kostakey/CountdownTimer/README.md

# Countdown Timer

## Starting a New Project
[help](https://docs.espressif.com/projects/vscode-esp-idf-extension/en/latest/startproject.html)
