kostakey/CountdownTimer/CountdownTimerOrderingSheet.xlsx

Sheet: OrderingList
Name | Description | Quantity | MFG PN | Cost per Unit | Price | Link | TOTAL
ESP32 C3 | MCU | 2 | ESP32-C3-WROOM-02-N4 | $3.380 | $6.760 | https://www.digikey.com/en/products/detail/espressif-systems/ESP32-C3-WROOM-02-N4/14553031 | $117.710
TLV1117LV33 | 3.3V LDO | 2 | TLV1117LV33DCYR | $0.260 | $0.520 | https://www.digikey.com/en/products/detail/texas-instruments/TLV1117LV33DCYR/2666508
0603 1u Cap |  | 15 | CL10B105KO8NNNC | $0.037 | $0.555 | https://www.digikey.com/en/products/detail/samsung-electro-mechanics/CL10B105KO8NNNC/3886677
12V-5V DCDC | 12V-5V DCDC, 0.5A, 6W | 2 | R-78E5.0-1.0 | $3.970 | $7.940 | https://www.digikey.com/en/products/detail/recom-power/R-78E5-0-1-0/4930585
0805 10u Cap | 10%, 16V, MLCC | 10 | CL21A106KOFNNNE | $0.091 | $0.910 | https://www.digikey.com/en/products/detail/samsung-electro-mechanics/CL21A106KOFNNNE/3888551
USB-UART Bridge |  | 2 | CP2102N-A02-GQFN28R | $5.100 | $10.200 | https://www.digikey.com/en/products/detail/silicon-labs/CP2102N-A02-GQFN28R/9863480
NPN Transistor | 40V, 0.6A | 4 | MMBT4401-7-F | $0.140 | $0.560 | https://www.digikey.com/en/products/detail/diodes-incorporated/MMBT4401-7-F/775841
USB-C Receptacle |  | 2 | 12401610E4#2A | $1.350 | $2.700 | https://www.digikey.com/en/products/detail/amphenol-cs-commercial-products/12401610E4-2A/5775519
TVS Diode | 19.9VC | 4 | SMAJ12CA | $0.480 | $1.920 | https://www.digikey.com/en/products/detail/littelfuse-inc/SMAJ12CA/762271
Schottky Diode | 40V, 1A | 2 | 1N5819HW-7-F | $0.290 | $0.580 | https://www.digikey.com/en/products/detail/diodes-incorporated/1N5819HW-7-F/814970
SPST Push Button |  | 3 | KMR213G LFG | $1.060 | $3.180 | https://www.digikey.com/en/products/detail/c-k/KMR213G-LFG/2176540
LED Driver, 8-Ch | Shift Registers, Current Sink | 10 | TLC5916IDR | $1.094 | $10.940 | https://www.digikey.com/en/products/detail/texas-instruments/TLC5916IDR/1726504
Red LEDs | Packs of 100 | 3 |  | $6.990 | $20.970 | https://www.amazon.com/dp/B077X95F7C?ref=ppx_yo2ov_dt_b_fed_asin_title&th=1
12VDC Barrel Jack Receptacle |  | 2 | PJ-063AH | $1.490 | $2.980 | https://www.digikey.com/en/products/detail/same-sky-formerly-cui-devices/PJ-063AH/2161208
Black FR4 | 2mm thick, 30cm x 17cm | 1 |  | $8.990 | $8.990 | https://www.amazon.com/gp/product/B0G6F9HTTK/ref=ewc_pr_img_2?smid=A3D5GC7GV7VRAI&psc=1
Perf board | Variety | 1 |  | $7.990 | $7.990 | https://www.amazon.com/gp/product/B0DBZ1BXFZ/ref=ewc_pr_img_2?smid=A1Z1ENBD0KSZ4W&psc=1
PCB headers |  | 1 |  | $10.990 | $10.990 | https://www.amazon.com/gp/product/B0774VBJ3J/ref=ewc_pr_img_1?smid=A3AX24NME6J6T3&th=1
0603 3A Fuse |  | 3 | SF-0603FP300-2 | $0.990 | $2.970 | https://www.digikey.com/en/products/detail/bourns-inc/SF-0603FP300-2/6153649
12V Wall Adapter |  | 1 |  | $12.990 | $12.990 | amazon.com/gp/product/B01GEA8PQA/ref=ox_sc_act_title_1?smid=AA0YO4F2UD50F&psc=1
0603 0 Res | 1/10W | 25 | RC0603JR-070RL | $0.009 | $0.220 | https://www.digikey.com/en/products/detail/yageo/RC0603JR-070RL/726675
0603 10k Res | 1/10W | 25 | RC0603FR-0710KL | $0.019 | $0.470 | https://www.digikey.com/en/products/detail/yageo/RC0603FR-0710KL/726880
0603 0.1u Cap | 16V | 25 | CL10B104KO8NNNC | $0.027 | $0.675 | https://www.digikey.com/en/products/detail/samsung-electro-mechanics/CL10B104KO8NNNC/3886663
0603 1k Res | 1/8W | 25 | CRCW06031K00FKEA | $0.024 | $0.600 | https://www.digikey.com/en/products/detail/vishay-dale/CRCW06031K00FKEA/1174668
0603 22.1k Res | 1/10W | 10 | RC0603FR-0722K1L | $0.025 | $0.250 | https://www.digikey.com/en/products/detail/yageo/RC0603FR-0722K1L/727058
0603 47.5k Res | 1/10W | 10 | RMCF0603FT47K5 | $0.021 | $0.210 | https://www.digikey.com/en/products/detail/stackpole-electronics-inc/RMCF0603FT47K5/1761143
0805 1.2k Res | Current limiting resistor | 25 | RC0805FR-071K2L | $0.026 | $0.640 | https://www.digikey.com/en/products/detail/yageo/RC0805FR-071K2L/727466

Sheet: PartsList
Name | Description | Designator | Quantity | MFG PN | Cost per Unit | Price | Link | TOTAL
 |  |  |  |  |  | #VALUE! |  | #VALUE!
 |  |  |  |  |  | #VALUE!
 |  |  |  |  |  | #VALUE!
 |  |  |  |  |  | #VALUE!
 |  |  |  |  |  | #VALUE!
 |  |  |  |  |  | #VALUE!
 |  |  |  |  |  | #VALUE!
 |  |  |  |  |  | #VALUE!
