kostakey/CountdownTimer/src/hardware/drillTemplate.pdf

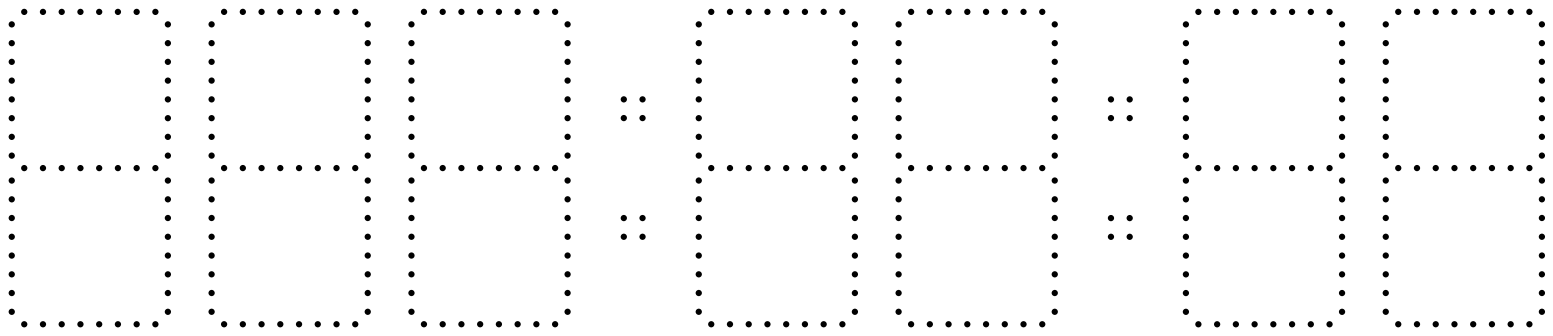
[picture p1: page 1]
