kostakey/CountdownTimer/src/hardware/CountdownTimerController/CountdownTimerController_V1.0.kicad_pcb

## KiCad design src/hardware/CountdownTimerController/CountdownTimerController_V1.0.kicad_pcb (2026-06-29)

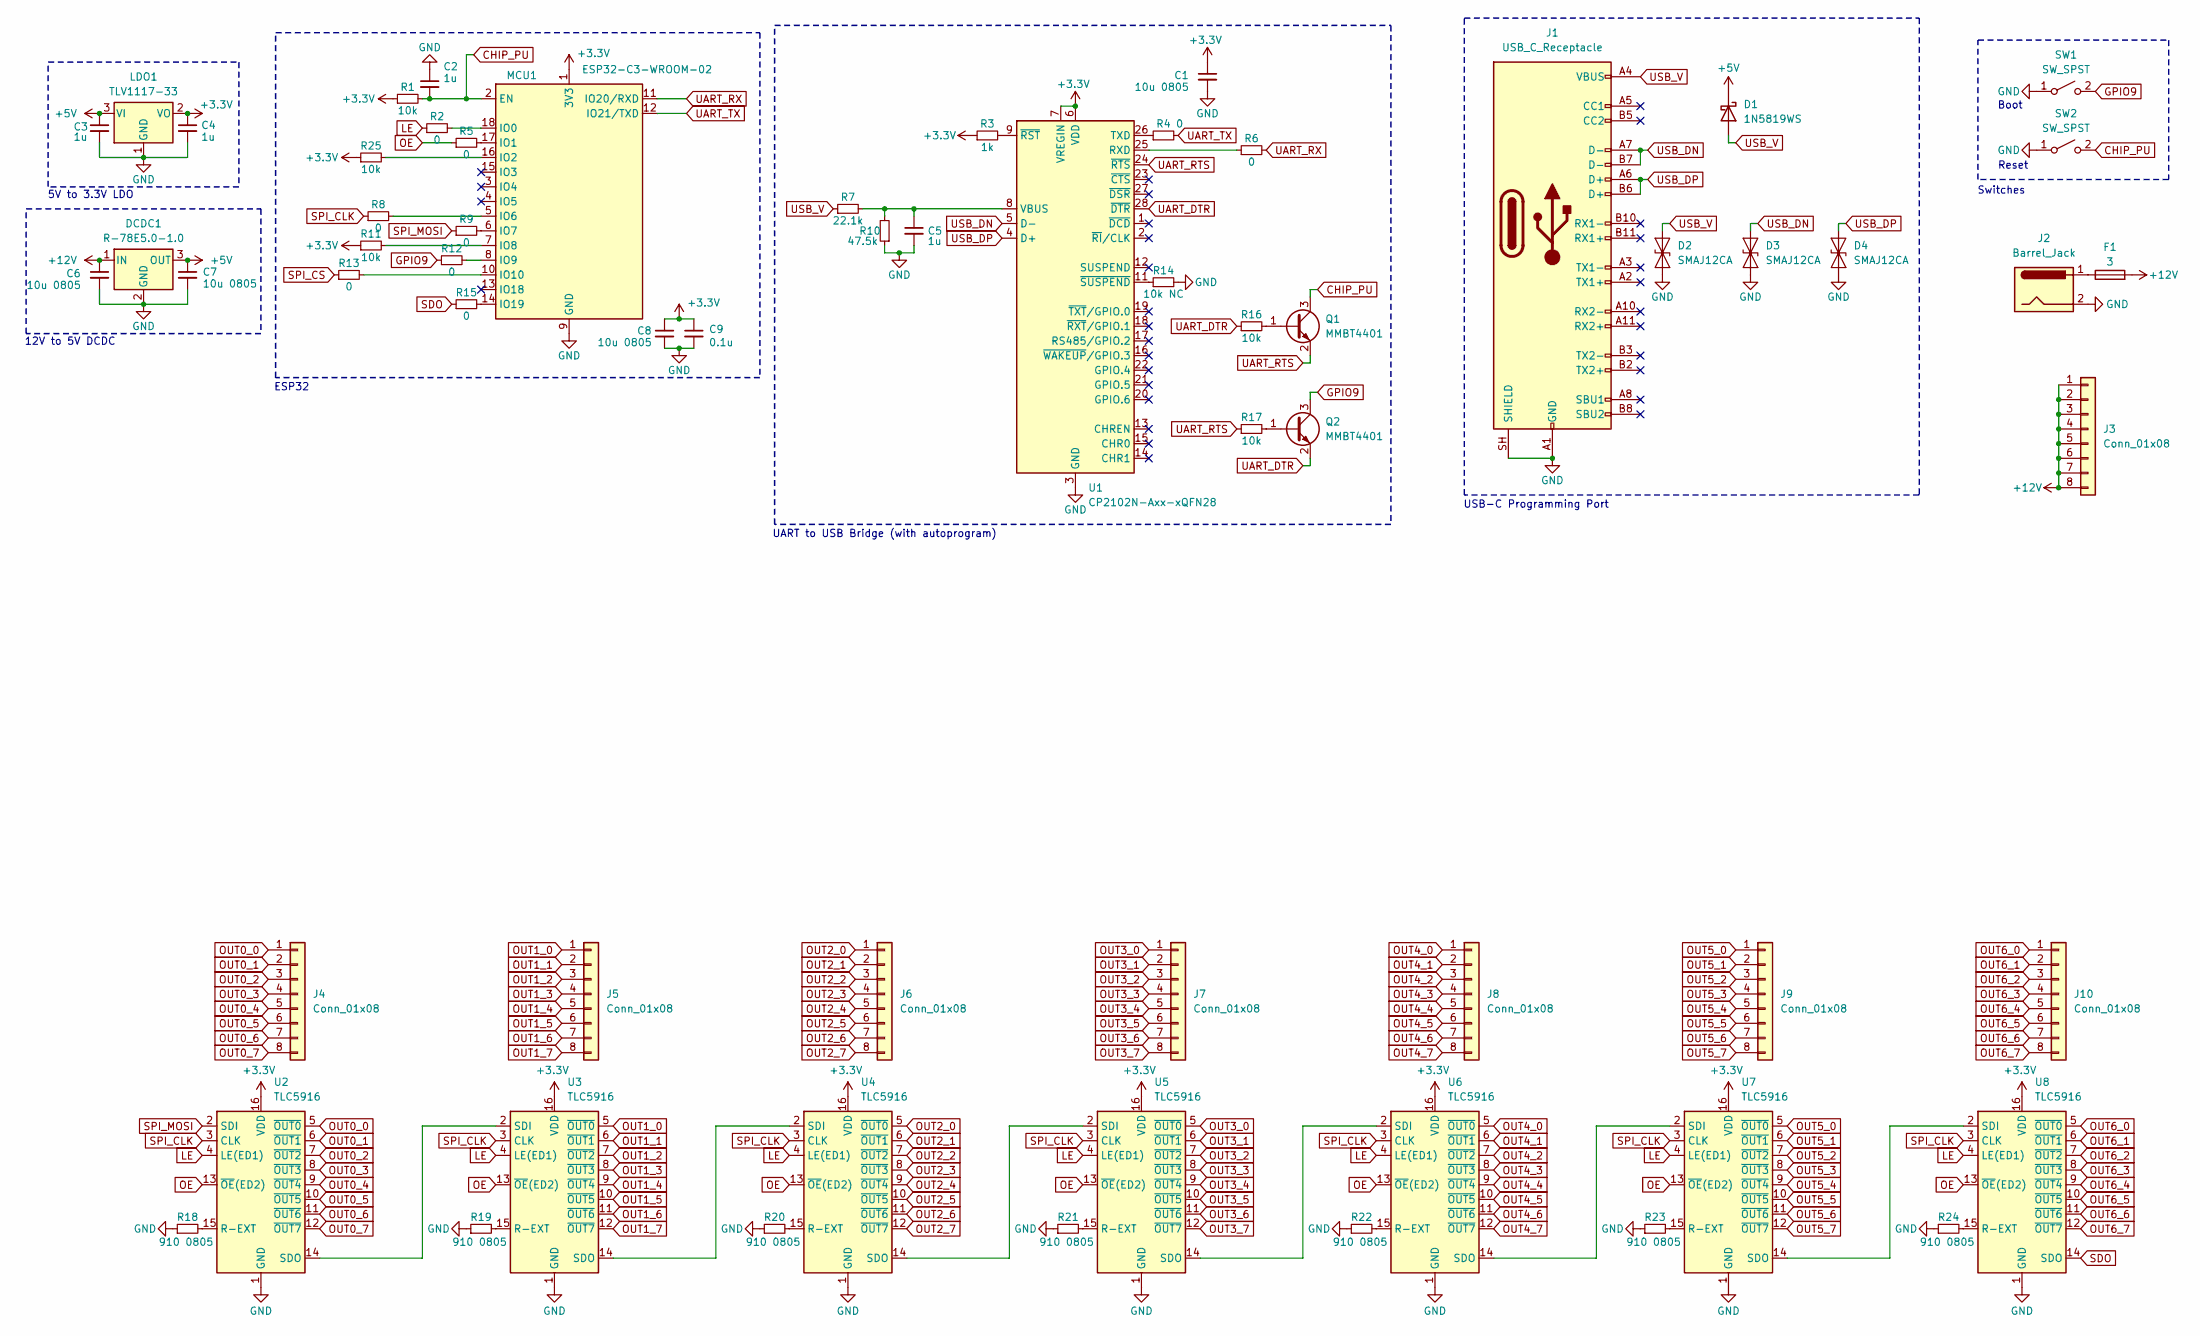
[picture p2: schematic CountdownTimerController_V1.0.kicad_sch, Countdown Timer Controller]

Parts:
C1, C6, C7, C8: 10u 0805; C_0805_2012Metric
C2, C3, C4, C5: 1u; C_0603_1608Metric
C9: 0.1u; C_0603_1608Metric
D1: 1N5819WS; D_SOD-123
D2, D3, D4: SMAJ12CA; D_SMA
DCDC1: R-78E5.0-1.0; Converter_DCDC_RECOM_R-78E-0.5_THT
F1: 3; Fuse_0603_1608Metric
J1: USB_C_Receptacle; USB_C_Receptacle_Amphenol_12401610E4-2A
J2: Barrel_Jack; BarrelJack_CUI_PJ-063AH_Horizontal
J3, J4, J5, J6, J7, J8, J9, J10: Conn_01x08; PinHeader_1x08_P2.54mm_Vertical
LDO1: TLV1117-33; SOT-223-3_TabPin2
MCU1: ESP32-C3-WROOM-02
Q1, Q2: MMBT4401; SOT-23
R1, R11, R16, R17, R25: 10k; R_0603_1608Metric
R2, R4, R5, R6, R8, R9, R12, R13, R15: 0; R_0603_1608Metric
R3: 1k; R_0603_1608Metric
R7: 22.1k; R_0603_1608Metric
R10: 47.5k; R_0603_1608Metric
R14: 10k NC; R_0603_1608Metric
R18, R19, R20, R21, R22, R23, R24: 910 0805; R_0805_2012Metric
SW1, SW2: SW_SPST; SW_Push_1P1T_NO_CK_KMR2
U1: CP2102N-Axx-xQFN28; QFN-28-1EP_5x5mm_P0.5mm_EP3.35x3.35mm
U2, U3, U4, U5, U6, U7, U8: TLC5916; SOIC-16_3.9x9.9mm_P1.27mm

Connections:
+3.3V: C1.1, C4.1, C8.1, C9.1, LDO1.2 (VO), MCU1.1 (3V3), R1.1, R3.1, R11.1, R25.1, U1.6 (VDD), U1.7 (VREGIN), U2.16 (VDD), U3.16 (VDD), U4.16 (VDD), U5.16 (VDD), U6.16 (VDD), U7.16 (VDD), U8.16 (VDD)
+5V: C3.1, C7.1, D1.1 (K), DCDC1.3 (OUT), LDO1.3 (VI)
+12V: C6.1, DCDC1.1 (IN), F1.2, J3.1, J3.2, J3.3, J3.4, J3.5, J3.6, J3.7, J3.8
CHIP_PU: C2.2, MCU1.2 (EN), Q1.3 (C), R1.2, SW2.2 (B)
GND: C1.2, C2.1, C3.2, C4.2, C5.2, C6.2, C7.2, C8.2, C9.2, D2.1 (A1), D3.1 (A1), D4.1 (A1), DCDC1.2 (GND), J1.A1 (GND), J1.A12 (GND), J1.B1 (GND), J1.B12 (GND), J1.SH (SHIELD), J2.2, LDO1.1 (GND), MCU1.9 (GND), MCU1.19 (GND), R10.1, R14.2, R18.1, R19.1, R20.1, R21.1, R22.1, R23.1, R24.1, SW1.1 (A), SW2.1 (A), U1.3 (GND), U1.29 (GND), U2.1 (GND), U3.1 (GND), U4.1 (GND), U5.1 (GND), U6.1 (GND), U7.1 (GND), U8.1 (GND)
GPIO9: Q2.3 (C), R12.1, SW1.2 (B)
LE: R2.1, U2.4 (LE(ED1)), U3.4 (LE(ED1)), U4.4 (LE(ED1)), U5.4 (LE(ED1)), U6.4 (LE(ED1)), U7.4 (LE(ED1)), U8.4 (LE(ED1))
unnamed: F1.1, J2.1
unnamed: MCU1.18 (IO0), R2.2
unnamed: MCU1.17 (IO1), R5.2
unnamed: MCU1.16 (IO2), R25.2
unnamed: MCU1.5 (IO6), R8.2
unnamed: MCU1.6 (IO7), R9.2
unnamed: MCU1.7 (IO8), R11.2
unnamed: MCU1.8 (IO9), R12.2
unnamed: MCU1.10 (IO10), R13.2
unnamed: MCU1.14 (IO19), R15.2
unnamed: Q1.1 (B), R16.2
unnamed: Q2.1 (B), R17.2
unnamed: R6.1, U1.25 (RXD)
unnamed: R4.1, U1.26 (TXD)
unnamed: C5.1, R7.2, R10.2, U1.8 (VBUS)
unnamed: R3.2, U1.9 (~RST)
unnamed: R14.1, U1.11 (~SUSPEND)
unnamed: R18.2, U2.15 (R-EXT)
unnamed: U2.14 (SDO), U3.2 (SDI)
unnamed: R19.2, U3.15 (R-EXT)
unnamed: U3.14 (SDO), U4.2 (SDI)
unnamed: R20.2, U4.15 (R-EXT)
unnamed: U4.14 (SDO), U5.2 (SDI)
unnamed: R21.2, U5.15 (R-EXT)
unnamed: U5.14 (SDO), U6.2 (SDI)
unnamed: R22.2, U6.15 (R-EXT)
unnamed: U6.14 (SDO), U7.2 (SDI)
unnamed: R23.2, U7.15 (R-EXT)
unnamed: U7.14 (SDO), U8.2 (SDI)
unnamed: R24.2, U8.15 (R-EXT)
OE: R5.1, U2.13 (~OE(ED2)), U3.13 (~OE(ED2)), U4.13 (~OE(ED2)), U5.13 (~OE(ED2)), U6.13 (~OE(ED2)), U7.13 (~OE(ED2)), U8.13 (~OE(ED2))
OUT0_0: J4.1, U2.5 (~OUT0)
OUT0_1: J4.2, U2.6 (~OUT1)
OUT0_2: J4.3, U2.7 (~OUT2)
OUT0_3: J4.4, U2.8 (~OUT3)
OUT0_4: J4.5, U2.9 (~OUT4)
OUT0_5: J4.6, U2.10 (~OUT5)
OUT0_6: J4.7, U2.11 (~OUT6)
OUT0_7: J4.8, U2.12 (~OUT7)
OUT1_0: J5.1, U3.5 (~OUT0)
OUT1_1: J5.2, U3.6 (~OUT1)
OUT1_2: J5.3, U3.7 (~OUT2)
OUT1_3: J5.4, U3.8 (~OUT3)
OUT1_4: J5.5, U3.9 (~OUT4)
OUT1_5: J5.6, U3.10 (~OUT5)
OUT1_6: J5.7, U3.11 (~OUT6)
OUT1_7: J5.8, U3.12 (~OUT7)
OUT2_0: J6.1, U4.5 (~OUT0)
OUT2_1: J6.2, U4.6 (~OUT1)
OUT2_2: J6.3, U4.7 (~OUT2)
OUT2_3: J6.4, U4.8 (~OUT3)
OUT2_4: J6.5, U4.9 (~OUT4)
OUT2_5: J6.6, U4.10 (~OUT5)
OUT2_6: J6.7, U4.11 (~OUT6)
OUT2_7: J6.8, U4.12 (~OUT7)
OUT3_0: J7.1, U5.5 (~OUT0)
OUT3_1: J7.2, U5.6 (~OUT1)
OUT3_2: J7.3, U5.7 (~OUT2)
OUT3_3: J7.4, U5.8 (~OUT3)
OUT3_4: J7.5, U5.9 (~OUT4)
OUT3_5: J7.6, U5.10 (~OUT5)
OUT3_6: J7.7, U5.11 (~OUT6)
OUT3_7: J7.8, U5.12 (~OUT7)
OUT4_0: J8.1, U6.5 (~OUT0)
OUT4_1: J8.2, U6.6 (~OUT1)
OUT4_2: J8.3, U6.7 (~OUT2)
OUT4_3: J8.4, U6.8 (~OUT3)
OUT4_4: J8.5, U6.9 (~OUT4)
OUT4_5: J8.6, U6.10 (~OUT5)
OUT4_6: J8.7, U6.11 (~OUT6)
OUT4_7: J8.8, U6.12 (~OUT7)
OUT5_0: J9.1, U7.5 (~OUT0)
OUT5_1: J9.2, U7.6 (~OUT1)
OUT5_2: J9.3, U7.7 (~OUT2)
OUT5_3: J9.4, U7.8 (~OUT3)
OUT5_4: J9.5, U7.9 (~OUT4)
OUT5_5: J9.6, U7.10 (~OUT5)
OUT5_6: J9.7, U7.11 (~OUT6)
OUT5_7: J9.8, U7.12 (~OUT7)
OUT6_0: J10.1, U8.5 (~OUT0)
OUT6_1: J10.2, U8.6 (~OUT1)
OUT6_2: J10.3, U8.7 (~OUT2)
OUT6_3: J10.4, U8.8 (~OUT3)
OUT6_4: J10.5, U8.9 (~OUT4)
OUT6_5: J10.6, U8.10 (~OUT5)
OUT6_6: J10.7, U8.11 (~OUT6)
OUT6_7: J10.8, U8.12 (~OUT7)
SDO: R15.1, U8.14 (SDO)
SPI_CLK: R8.1, U2.3 (CLK), U3.3 (CLK), U4.3 (CLK), U5.3 (CLK), U6.3 (CLK), U7.3 (CLK), U8.3 (CLK)
SPI_CS: R13.1
SPI_MOSI: R9.1, U2.2 (SDI)
UART_DTR: Q2.2 (E), R16.1, U1.28 (~DTR)
UART_RTS: Q1.2 (E), R17.1, U1.24 (~RTS)
UART_RX: MCU1.11 (IO20/RXD), R6.2
UART_TX: MCU1.12 (IO21/TXD), R4.2
USB_DN: D3.2 (A2), J1.A7 (D-), J1.B7 (D-), U1.5 (D-)
USB_DP: D4.2 (A2), J1.A6 (D+), J1.B6 (D+), U1.4 (D+)
USB_V: D1.2 (A), D2.2 (A2), J1.A4 (VBUS), J1.A9 (VBUS), J1.B4 (VBUS), J1.B9 (VBUS), R7.1

Notes on the sheet:
12V to 5V DCDC
Reset
Boot
5V to 3.3V LDO
ESP32
Switches
USB-C Programming Port
UART to USB Bridge (with autoprogram)

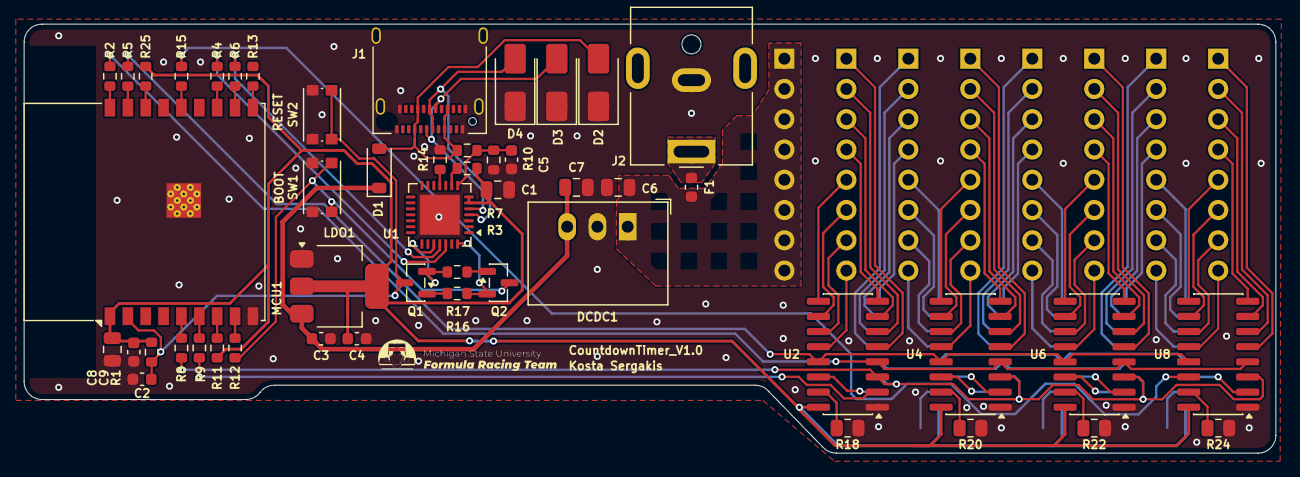
[picture p3: board CountdownTimerController_V1.0.kicad_pcb from above]

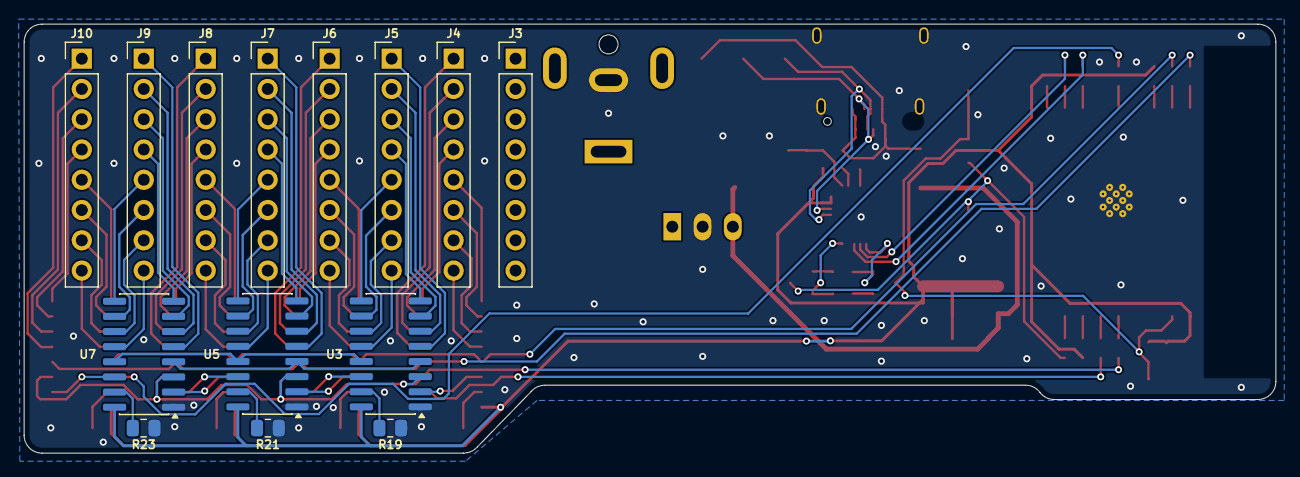
[picture p4: board CountdownTimerController_V1.0.kicad_pcb from below]

Board: 2 copper layers, 105.0 x 36.0 mm, 64 parts (14 on the bottom side), 104 nets.
